SwiftCircuits/SwiftModule/README.md

# SwiftModule
A repo containing production files for a large variety of modules of sensors or other integrated circuits.
