SwiftCircuits/SwiftModule/Raw Libs/QFN-16_MA730_MNP.step

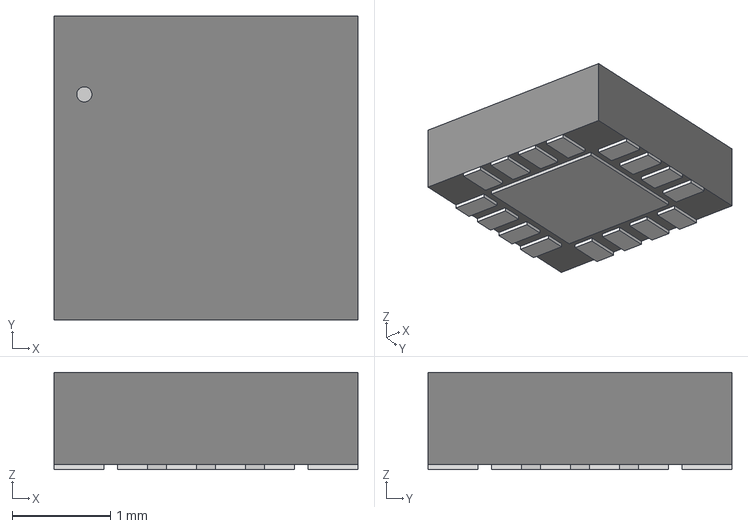
[picture p1: CAD file, 2025-03-04]
Raw Libs/QFN-16_MA730_MNP.step
3.10 x 3.10 x 0.993 mm
