SwiftCircuits/SwiftModule/Raw Libs/RT9013-18GB/3D/RT9013-18GB.stp

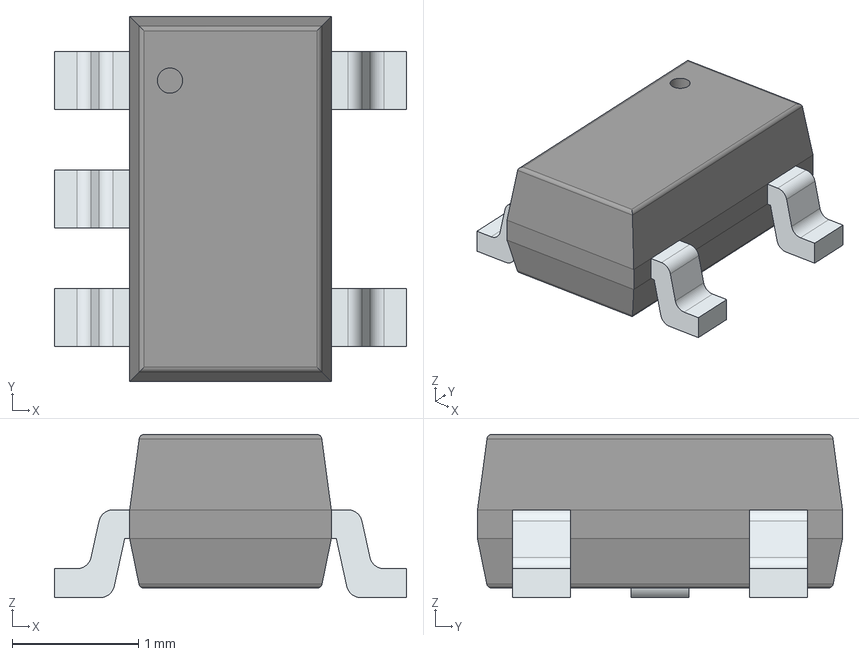
[picture p2: CAD file, 2025-03-04]
Raw Libs/RT9013-18GB/3D/RT9013-18GB.stp
2.79 x 2.90 x 1.29 mm
PinsArrayL
PinsArrayR
