SwiftCircuits/SwiftModule/Raw Libs/TXB0108PWR/3D/TXB0108PWR.stp

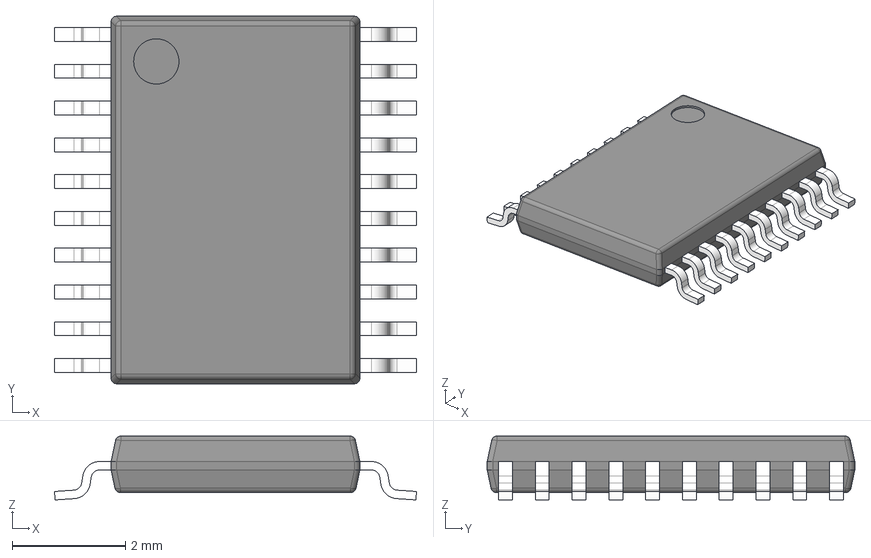
[picture p3: CAD file, 2025-03-04]
Raw Libs/TXB0108PWR/3D/TXB0108PWR.stp
6.40 x 6.50 x 1.13 mm
BODY-TSSOP
LEAD-TSSOP x 20
PIN1
