SwiftCircuits/SwiftModule/Raw Libs/TXB0108RGYR/3D/TXB0108RGYR.stp

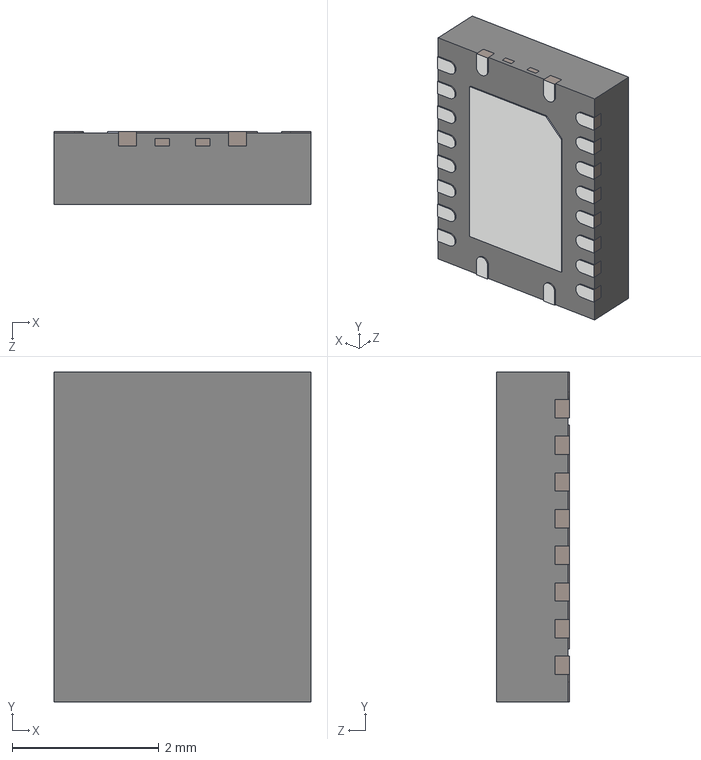
[picture p4: CAD file, 2025-03-04]
Raw Libs/TXB0108RGYR/3D/TXB0108RGYR.stp
3.50 x 4.50 x 1 mm
