SwiftCircuits/SwiftModule/Raw Libs/VL53L4CXV0DH_1/3D/VL53L4CXV0DH_1.stp

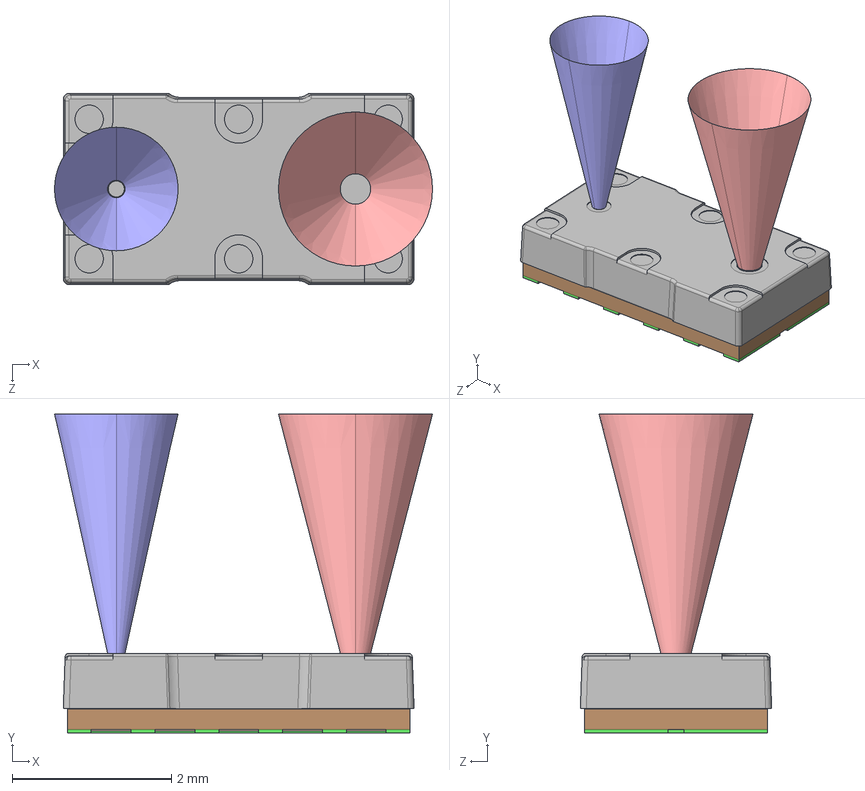
[picture p5: CAD file, 2025-03-04]
Raw Libs/VL53L4CXV0DH_1/3D/VL53L4CXV0DH_1.stp
4.74 x 4.00 x 2.40 mm
VL53L4 Substrate
VL53L4 Cap
VL53L4 Tx Exclusion Cone
VL53L4 Rx Exclusion Cone
