SwiftCircuits/SwiftModule/Raw Libs/VL53L5CXV0GC_1/3D/VL53L5CXV0GC_1.stp

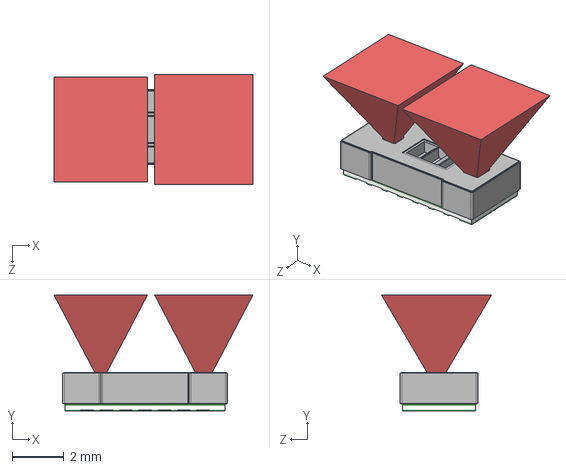
[picture p6: CAD file, 2025-03-04]
Raw Libs/VL53L5CXV0GC_1/3D/VL53L5CXV0GC_1.stp
7.72 x 4.50 x 4.28 mm
VL53L5 Module
VL53L5 Exclusion cones
