SwiftCircuits/SwiftModule/Raw Libs/VL53L8CXV0GC_1/3D/VL53L8CXV0GC_1.stp

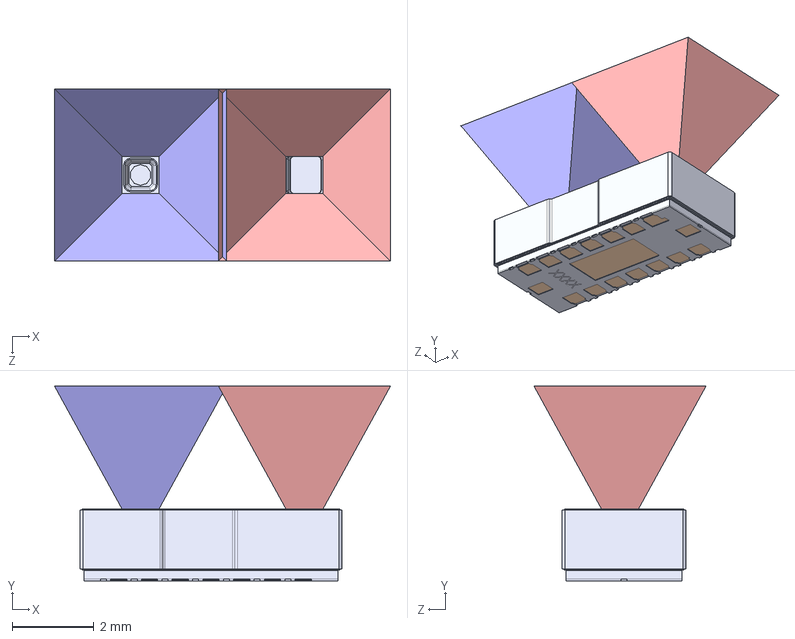
[picture p7: CAD file, 2025-03-04]
Raw Libs/VL53L8CXV0GC_1/3D/VL53L8CXV0GC_1.stp
8.20 x 4.75 x 4.20 mm
VL53L8 SUBSTRATE
VL53L8 CAP
VL53L8 Rx Exclusion Cone
VL53L8 Tx Exclusion Cone
