SwiftCircuits/SwiftModule/(list of files, cad)

Other CAD files:
Raw Libs/RT9013-18GB/Allegro/sot94p279x130-5n.psm
Raw Libs/RT9013-18GB/DEHDL/rt9013_18gb/chips/chips.prt
