SwiftCircuits/SwiftModule/2. VL53L5CX/Swift_Module_VL53L5CX.kicad_pcb

## KiCad design 2. VL53L5CX/Swift_Module_VL53L5CX.kicad_pcb (2025-05-03)

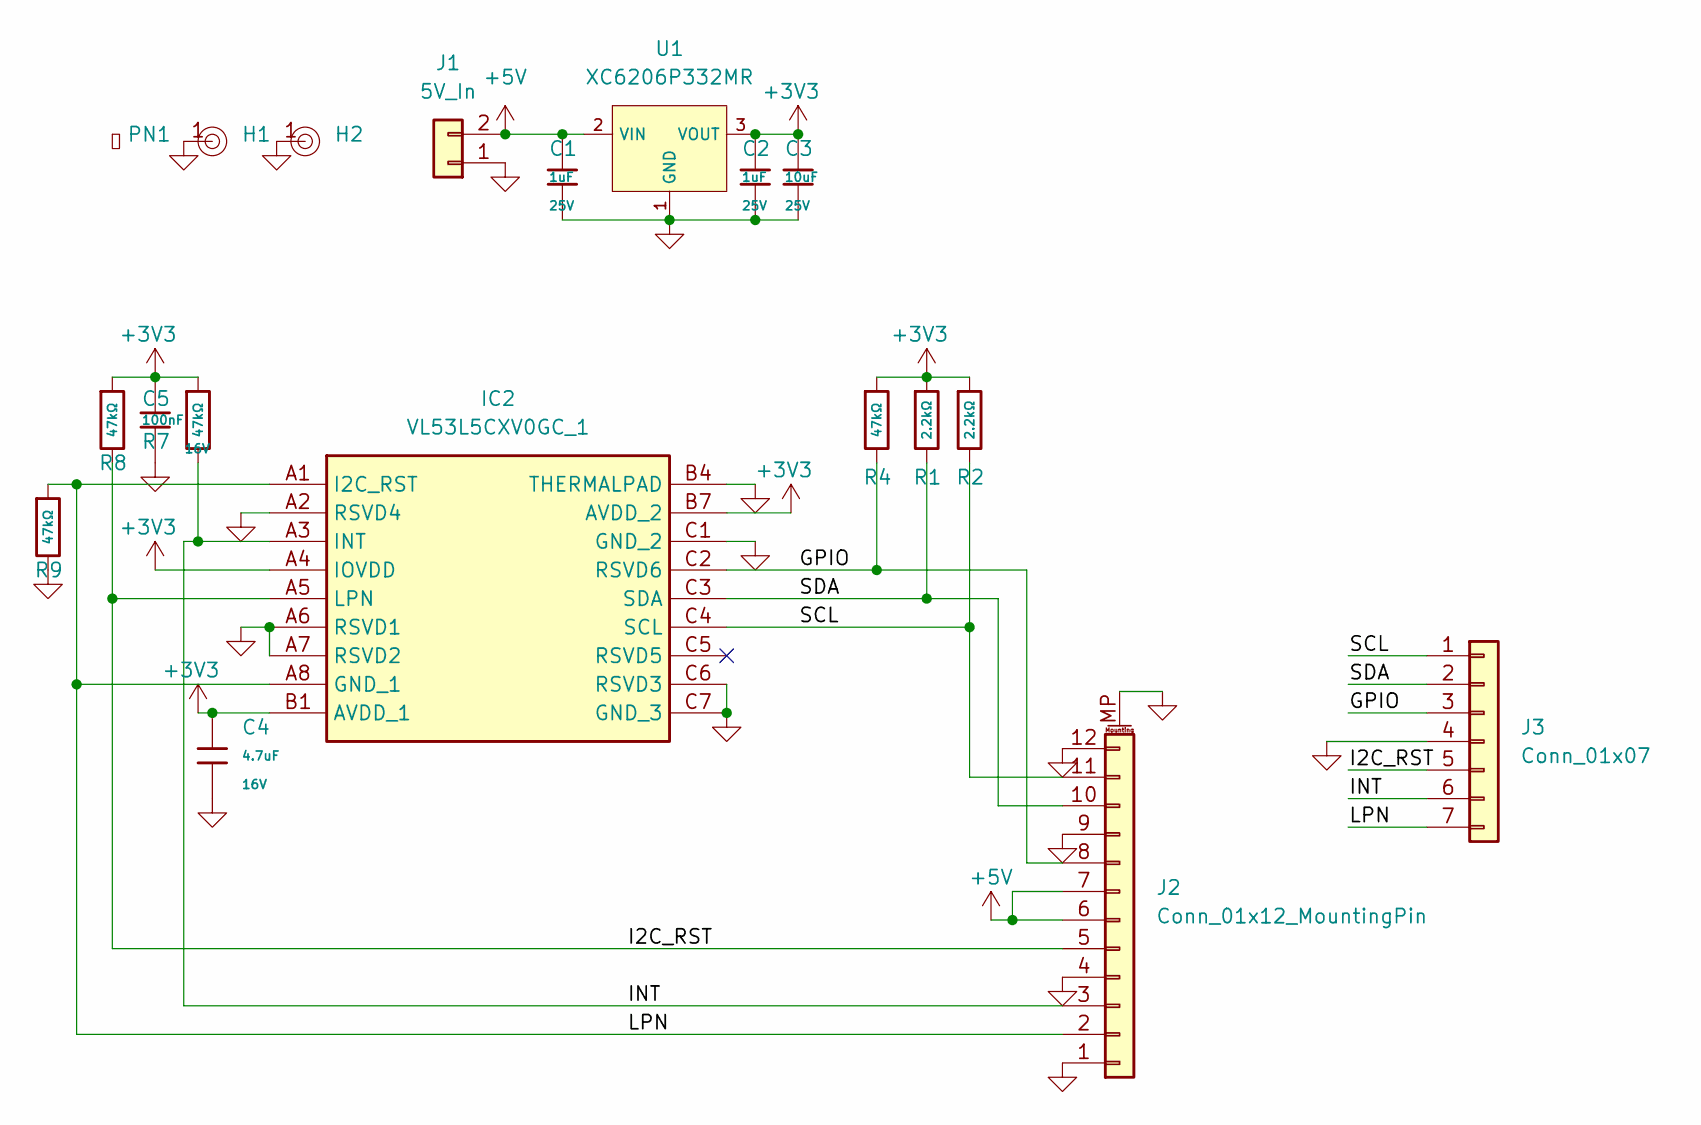
[picture p8: schematic Swift_Module_VL53L5CX.kicad_sch]

Parts:
C1, C2: 1uF; C_0402; Voltage Rated 25V; Tolerance ±10%; Part CL05A105KA5NQNC; LCSC C52923
C3: 10uF; C_0603; Voltage Rated 25V; Tolerance ±20%; Part CL10A106MA8NRNC; LCSC C96446
C4: 4.7uF; C_0603; Voltage Rated 16V; Tolerance ±10%; Part CL10A475KO8NNNC; LCSC C19666
C5: 100nF; C_0402; Voltage Rated 16V; Tolerance ±10%; Part CL05B104KO5NNNC; LCSC C1525
H1, H2: Hole, 3mm
IC2: VL53L5CXV0GC_1; VL53L5CXV0GC1; Mouser Part Number 511-VL53L5CXV0GC/1
J1: 5V_In; JST_XH_B2B-XH-A_1x02_P2.50mm_Vertical
J2: Conn_01x12_MountingPin; Hirose_FH12-12S-0.5SH_1x12-1MP_P0.50mm_Horizontal; LCSC C88360
J3: Conn_01x07; PinHeader_1x07_P2.54mm_Vertical
PN1: Part_Num_JLCPCB
R1, R2: 2.2kΩ; R_0402; Overload Voltage (Max) 50V; Tolerance ±1%; Part 0402WGF2201TCE; LCSC C25879
R4, R7, R8, R9: 47kΩ; R_0402; Overload Voltage (Max) 50V; Tolerance ±1%; Part 0402WGF4702TCE; LCSC C25792
U1: XC6206P332MR; SOT-23-3_L2.9-W1.6-P1.90-LS2.8-BR; Output Voltage 3.3V; Dropout Voltage 680mV@(100mA); Part XC6206P332MR-G; LCSC C5446

Connections:
+3V3: C2.1, C3.1, C4.1, C5.1, IC2.A4 (IOVDD), IC2.B1 (AVDD_1), IC2.B7 (AVDD_2), R1.1, R2.1, R4.1, R7.1, R8.1, U1.3 (VOUT)
+5V: C1.1, J1.2, J2.6, J2.7, U1.2 (VIN)
/GPIO: IC2.C2 (RSVD6), J2.8, J3.3, R4.2
/I2C_RST: IC2.A5 (LPN), J2.5, J3.5, R8.2
/INT: IC2.A3 (INT), J2.3, J3.6, R7.2
/LPN: IC2.A1 (I2C_RST), IC2.A8 (GND_1), J2.2, J3.7, R9.1
/SCL: IC2.C4 (SCL), J2.11, J3.1, R2.2
/SDA: IC2.C3 (SDA), J2.10, J3.2, R1.2
GND: C1.2, C2.2, C3.2, C4.2, C5.2, H1.1, H2.1, IC2.A2 (RSVD4), IC2.A6 (RSVD1), IC2.A7 (RSVD2), IC2.B4 (THERMALPAD), IC2.C1 (GND_2), IC2.C6 (RSVD3), IC2.C7 (GND_3), J1.1, J2.1, J2.4, J2.9, J2.12, J2.MP (MountPin), J3.4, R9.2, U1.1 (GND)

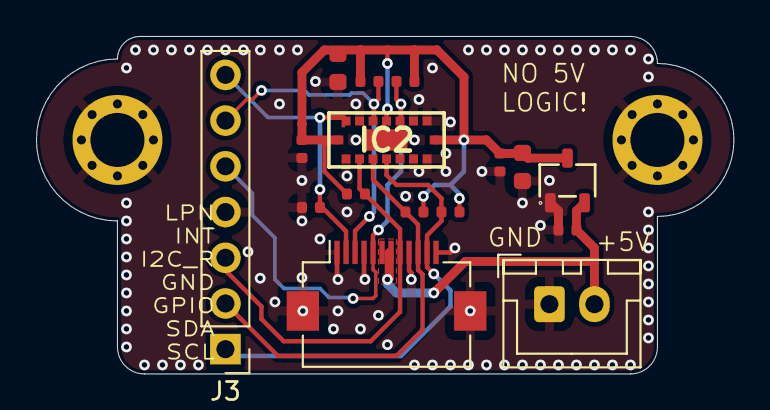
[picture p9: board Swift_Module_VL53L5CX.kicad_pcb from above]

Board: 4 copper layers, 38.8 x 18.8 mm, 18 parts (0 on the bottom side), 9 nets.
