SwiftCircuits/SwiftModule/3. MA730/3. MA730.kicad_pcb

## KiCad design 3. MA730/3. MA730.kicad_pcb (2025-03-04)

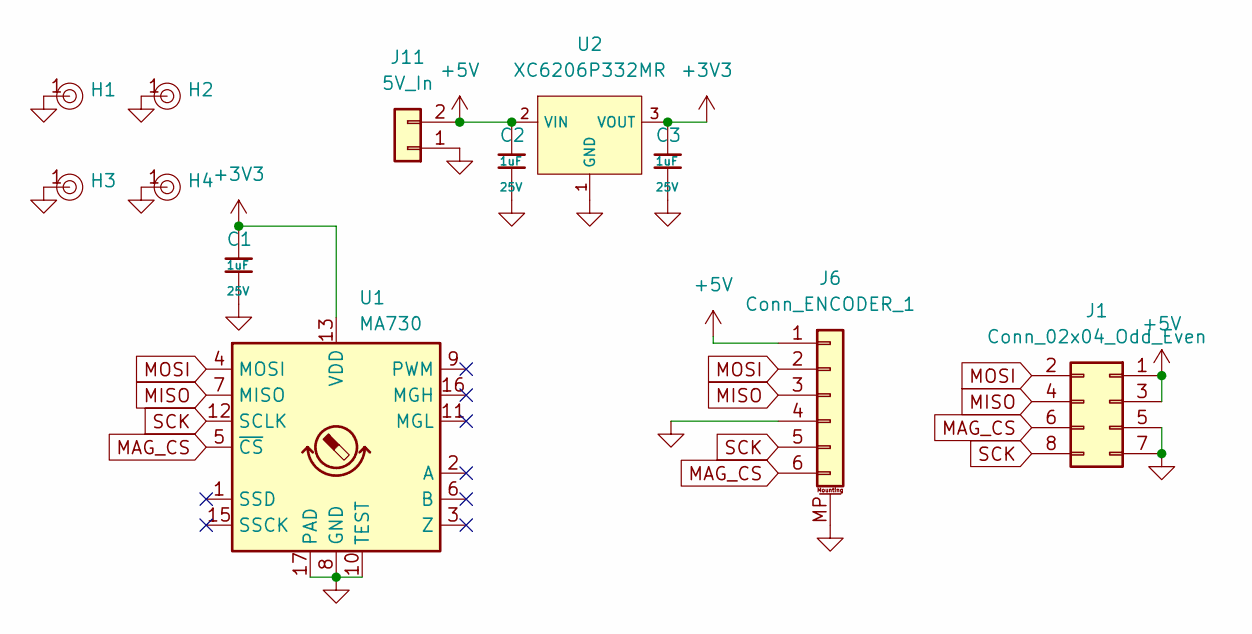
[picture p10: schematic 3. MA730.kicad_sch]

Parts:
C1, C2, C3: 1uF; C_0402; Voltage Rated 25V; Tolerance ±10%; Part CL05A105KA5NQNC; LCSC C52923
H1, H2, H3, H4: Hole, 3mm
J1: Conn_02x04_Odd_Even; PinHeader_2x04_P2.54mm_Vertical
J6: Conn_ENCODER_1; Hirose_FH12-6S-0.5SH_1x06-1MP_P0.50mm_Horizontal
J11: 5V_In; JST_XH_B2B-XH-A_1x02_P2.50mm_Vertical
U1: MA730; QFN-16-1EP_3x3mm_P0.5mm_EP1.75x1.75mm
U2: XC6206P332MR; SOT-23-3_L2.9-W1.6-P1.90-LS2.8-BR; Output Voltage 3.3V; Dropout Voltage 680mV@(100mA); Part XC6206P332MR-G; LCSC C5446

Connections:
+3V3: C1.1, C3.1, U1.13 (VDD), U2.3 (VOUT)
+5V: C2.1, J1.1, J1.3, J6.1, J11.2, U2.2 (VIN)
GND: C1.2, C2.2, C3.2, H1.1, H2.1, H3.1, H4.1, J1.5, J1.7, J6.4, J6.MP (MountPin), J11.1, U1.8 (GND), U1.10 (TEST), U1.17 (PAD), U2.1 (GND)
MAG_CS: J1.6, J6.6, U1.5 (~CS)
MISO: J1.4, J6.3, U1.7 (MISO)
MOSI: J1.2, J6.2, U1.4 (MOSI)
SCK: J1.8, J6.5, U1.12 (SCLK)

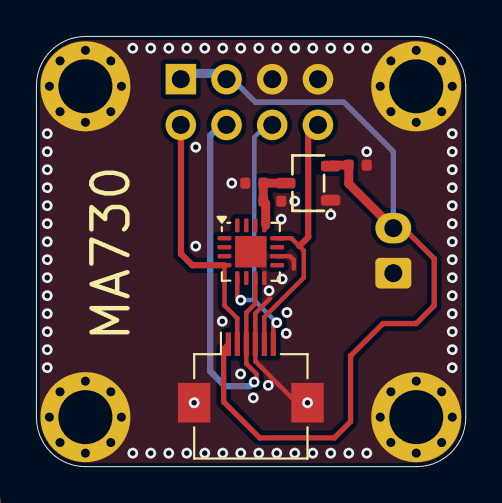
[picture p11: board 3. MA730.kicad_pcb from above]

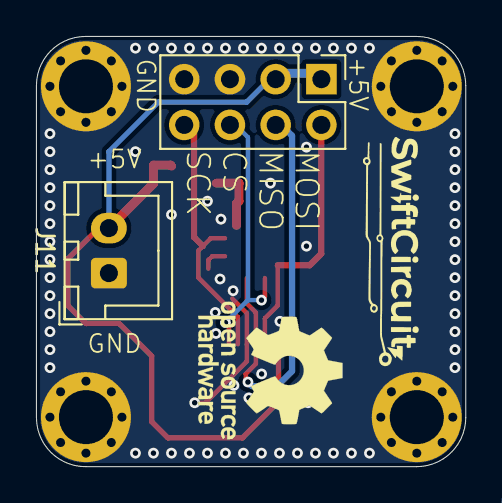
[picture p12: board 3. MA730.kicad_pcb from below]

Board: 4 copper layers, 23.8 x 23.9 mm, 12 parts (2 on the bottom side), 7 nets.
