SwiftCircuits/SwiftModule/VL53L8CX/Swift_Module_VL53L8CX/Swift_Module_VL53L8CX.kicad_pcb

## KiCad design VL53L8CX/Swift_Module_VL53L8CX/Swift_Module_VL53L8CX.kicad_pcb (2025-03-04)

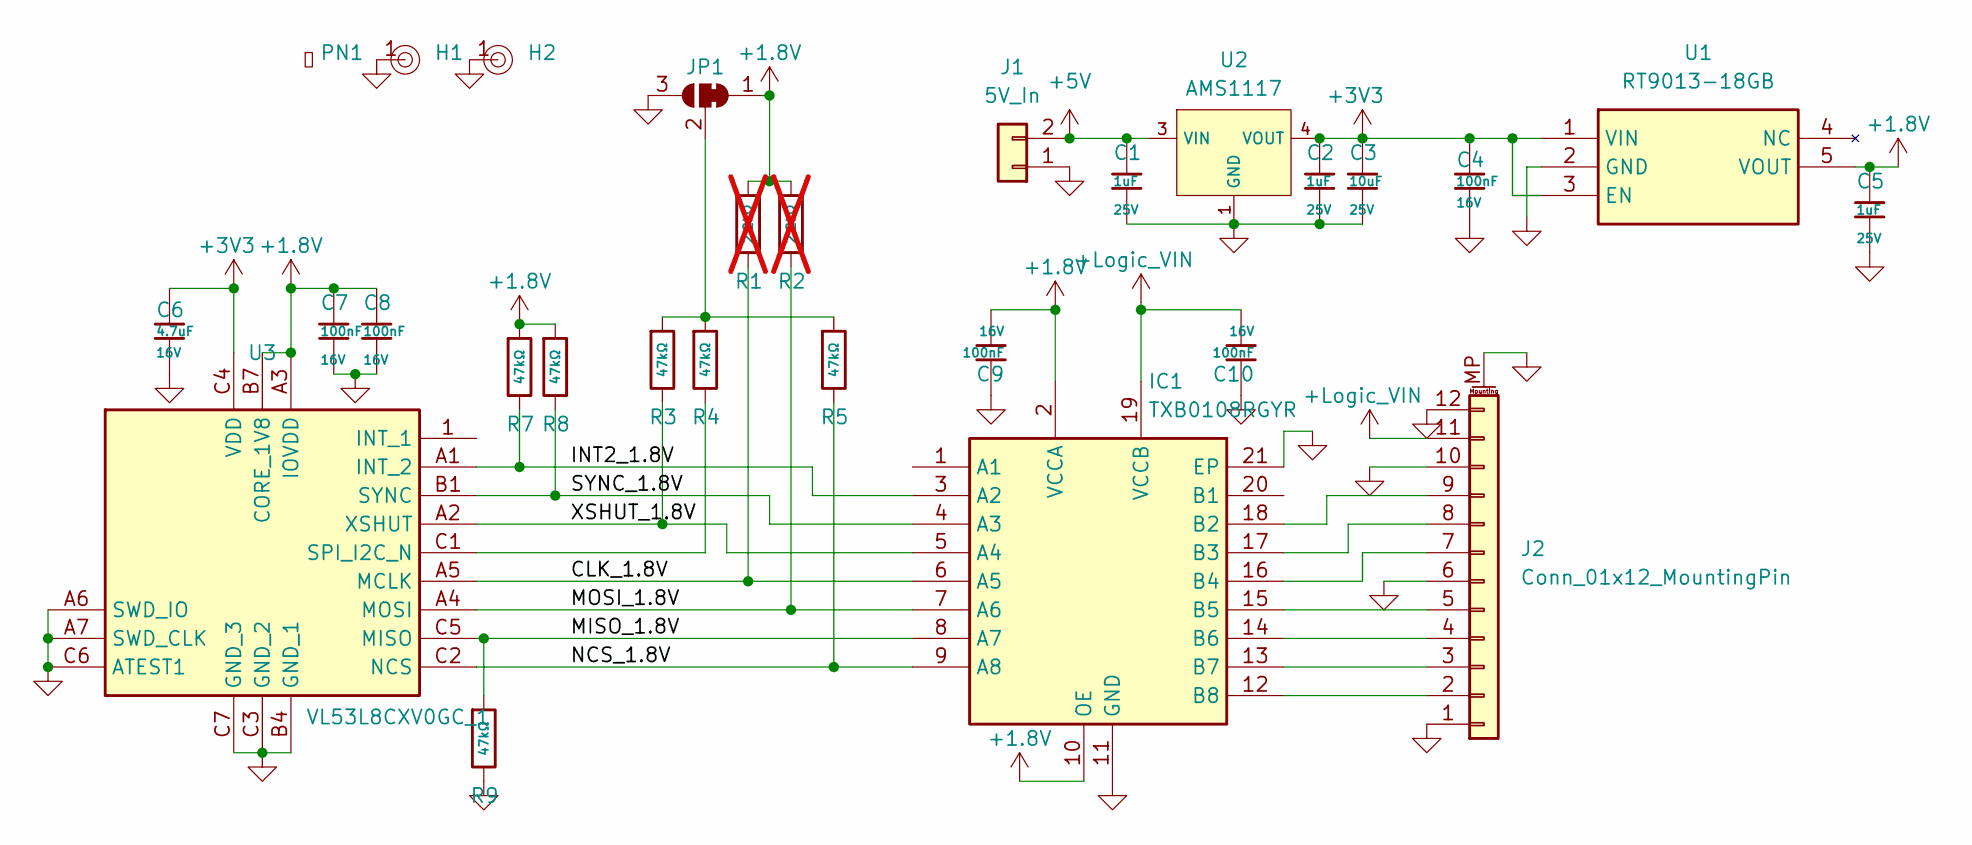
[picture p13: schematic Swift_Module_VL53L8CX.kicad_sch]

Parts:
C1, C2, C5: 1uF; C_0402; Voltage Rated 25V; Tolerance ±10%; Part CL05A105KA5NQNC; LCSC C52923
C3: 10uF; C_0603; Voltage Rated 25V; Tolerance ±20%; Part CL10A106MA8NRNC; LCSC C96446
C4, C7, C8, C9, C10: 100nF; C_0402; Voltage Rated 16V; Tolerance ±10%; Part CL05B104KO5NNNC; LCSC C1525
C6: 4.7uF; C_0603; Voltage Rated 16V; Tolerance ±10%; Part CL10A475KO8NNNC; LCSC C19666
H1, H2: Hole, 3mm
IC1: TXB0108RGYR; SN74LVC541ARGYR; Mouser Part Number 595-TXB0108RGYR
J1: 5V_In; JST_XH_B2B-XH-A_1x02_P2.50mm_Vertical
J2: Conn_01x12_MountingPin; Hirose_FH12-12S-0.5SH_1x12-1MP_P0.50mm_Horizontal; LCSC C88360
JP1: SolderJumper_3_Bridged12; SolderJumper-3_P1.3mm_Bridged2Bar12_RoundedPad1.0x1.5mm
PN1: Part_Num_JLCPCB
R1, R2: 2.2kΩ; R_0402; Overload Voltage (Max) 50V; Tolerance ±1%; Part 0402WGF2201TCE; LCSC C25879; not fitted
R3, R4, R5, R7, R8, R9: 47kΩ; R_0402; Overload Voltage (Max) 50V; Tolerance ±1%; Part 0402WGF4702TCE; LCSC C25792
U1: RT9013-18GB; SOT94P279X130-5N; Mouser Part Number 835-RT9013-18GB
U2: AMS1117; SOT-223-3_L6.5-W3.4-P2.30-LS7.0-BR; Output Voltage 3.3V; Dropout Voltage 1.3V@(800mA); Part AMS1117-3.3; LCSC C6186
U3: VL53L8CXV0GC_1; VL53L8CXV0GC1; Mouser Part Number 511-VL53L8CXV0GC/1

Connections:
+1.8V: C5.1, C7.1, C8.1, C9.2, IC1.2 (VCCA), IC1.10 (OE), JP1.1 (A), R1.1, R2.1, R7.1, R8.1, U1.5 (VOUT), U3.A3 (IOVDD), U3.B7 (CORE_1V8)
+3V3: C2.1, C3.1, C4.1, C6.1, U1.1 (VIN), U1.3 (EN), U2.2 (VOUT), U2.4 (VOUT), U3.C4 (VDD)
+5V: C1.1, J1.2, U2.3 (VIN)
+Logic_VIN: C10.2, IC1.19 (VCCB), J2.11
/CLK_1.8V: IC1.6 (A5), R1.2, U3.A5 (MCLK)
/INT2_1.8V: IC1.3 (A2), R7.2, U3.A1 (INT_2)
/MISO_1.8V: IC1.8 (A7), R9.1, U3.C5 (MISO)
/MOSI_1.8V: IC1.7 (A6), R2.2, U3.A4 (MOSI)
/NCS_1.8V: IC1.9 (A8), R5.2, U3.C2 (NCS)
/SYNC_1.8V: IC1.4 (A3), R8.2, U3.B1 (SYNC)
/XSHUT_1.8V: IC1.5 (A4), R3.2, U3.A2 (XSHUT)
GND: C1.2, C2.2, C3.2, C4.2, C5.2, C6.2, C7.2, C8.2, C9.1, C10.1, H1.1, H2.1, IC1.11 (GND), IC1.21 (EP), J1.1, J2.1, J2.6, J2.10, J2.12, J2.MP (MountPin), JP1.3 (B), R9.2, U1.2 (GND), U2.1 (GND), U3.A6 (SWD_IO), U3.A7 (SWD_CLK), U3.B4 (GND_1), U3.C3 (GND_2), U3.C6 (ATEST1), U3.C7 (GND_3)
unnamed: IC1.18 (B2), J2.9
unnamed: IC1.17 (B3), J2.8
unnamed: IC1.16 (B4), J2.7
unnamed: IC1.15 (B5), J2.5
unnamed: IC1.14 (B6), J2.4
unnamed: IC1.13 (B7), J2.3
unnamed: IC1.12 (B8), J2.2
unnamed: JP1.2 (C), R3.1, R4.1, R5.1
unnamed: R4.2, U3.C1 (SPI_I2C_N)

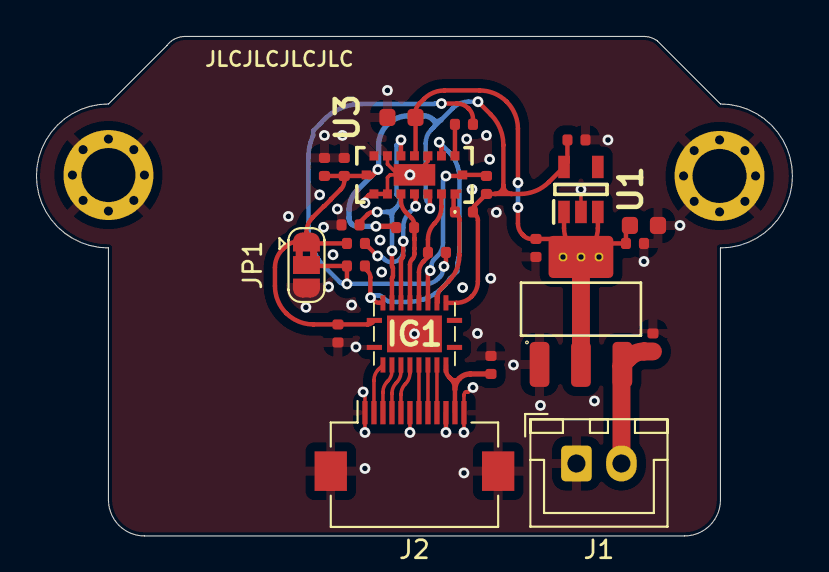
[picture p14: board Swift_Module_VL53L8CX.kicad_pcb from above]

Board: 4 copper layers, 42.0 x 27.8 mm, 28 parts (0 on the bottom side), 21 nets.
